Jaycar-Electronics/Christmas-Light-Controller/images/lightsup.jpg

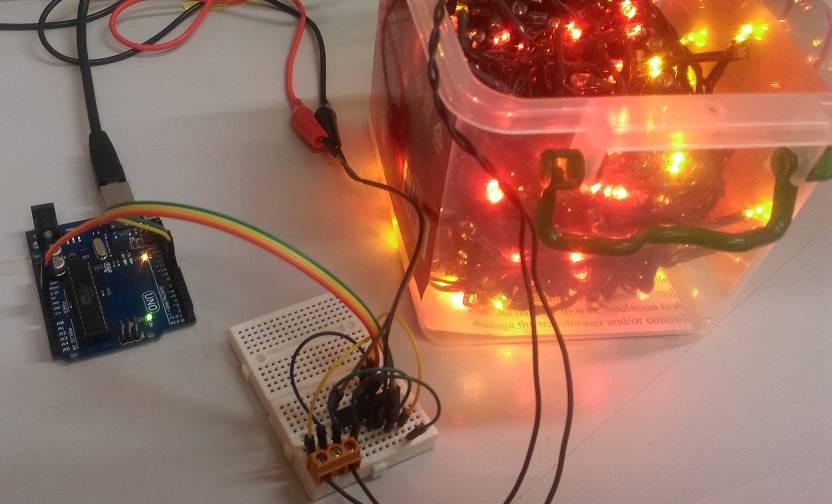
images/lightsup.jpg
