Jaycar-Electronics/Christmas-Light-Controller/images/socket.jpg

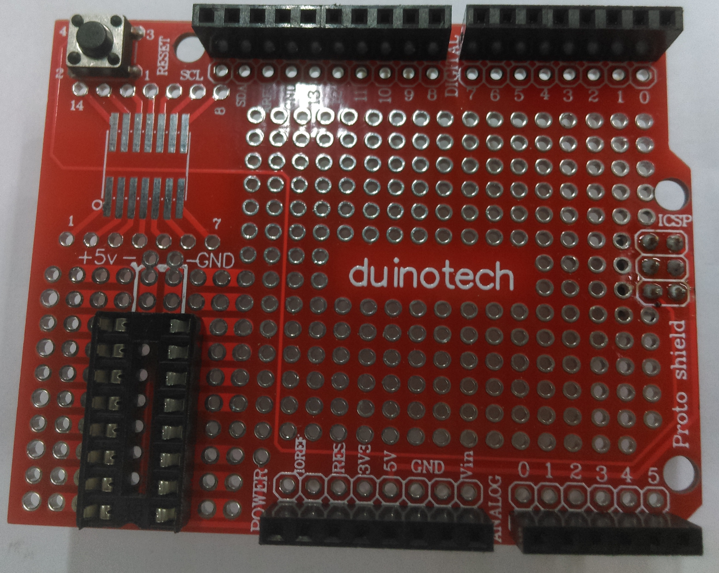
images/socket.jpg
