Jaycar-Electronics/Christmas-Light-Controller/images/soldering.jpg

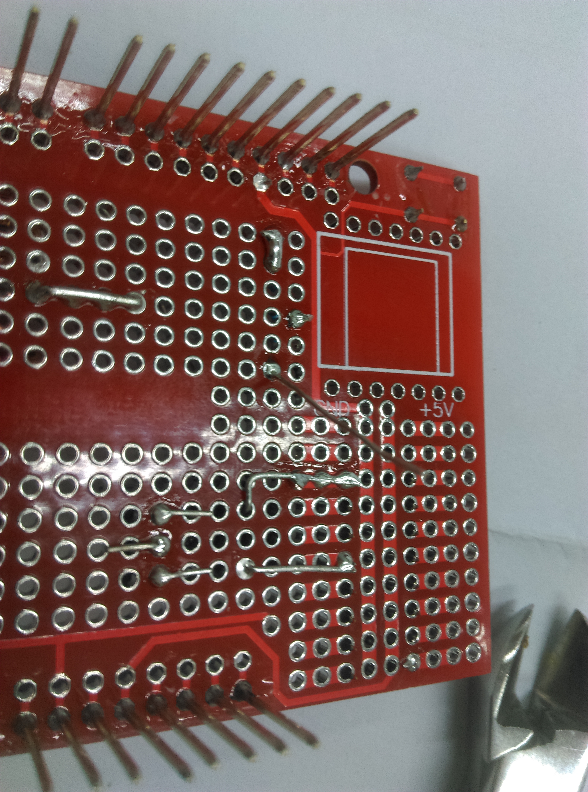
images/soldering.jpg
